CalamaroS/FOT-wirless-device/0_Documenti/ESP32/TTGO_esp32_pinout.webp

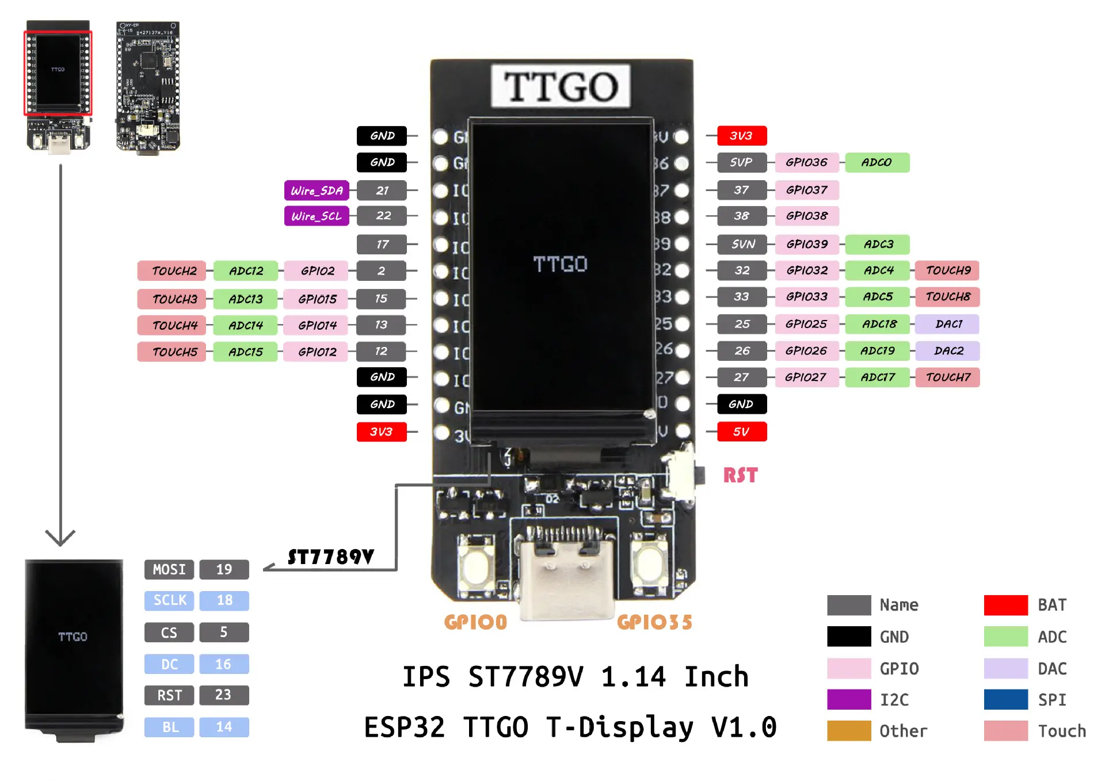
0_Documenti/ESP32/TTGO_esp32_pinout.webp
