CalamaroS/FOT-wirless-device/0_Documenti/ESP32/TTGO_esp32_footprint.webp

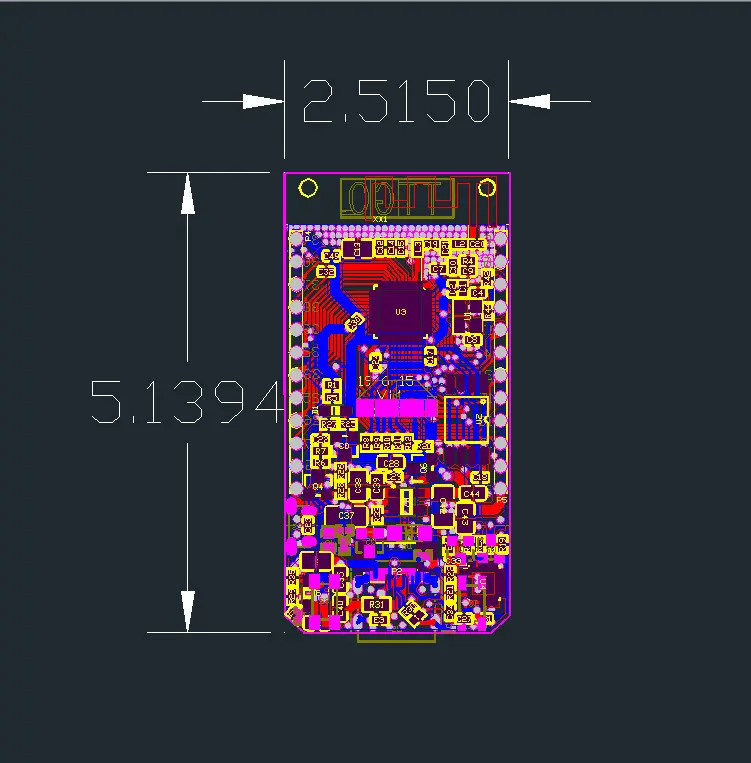
0_Documenti/ESP32/TTGO_esp32_footprint.webp
