CalamaroS/FOT-wirless-device/README.md

# FOT-wirless-device
Master thesis project: Development of a wireless device for lung function assessment in horses.
