CalamaroS/FOT-wirless-device/5_PCB_cad/HorseFOT_thomas_SD_P_abs/HorseFOT_thomas_v1.kicad_pcb

## KiCad design 5_PCB_cad/HorseFOT_thomas_SD_P_abs/HorseFOT_thomas_v1.kicad_pcb (2024-09-25)

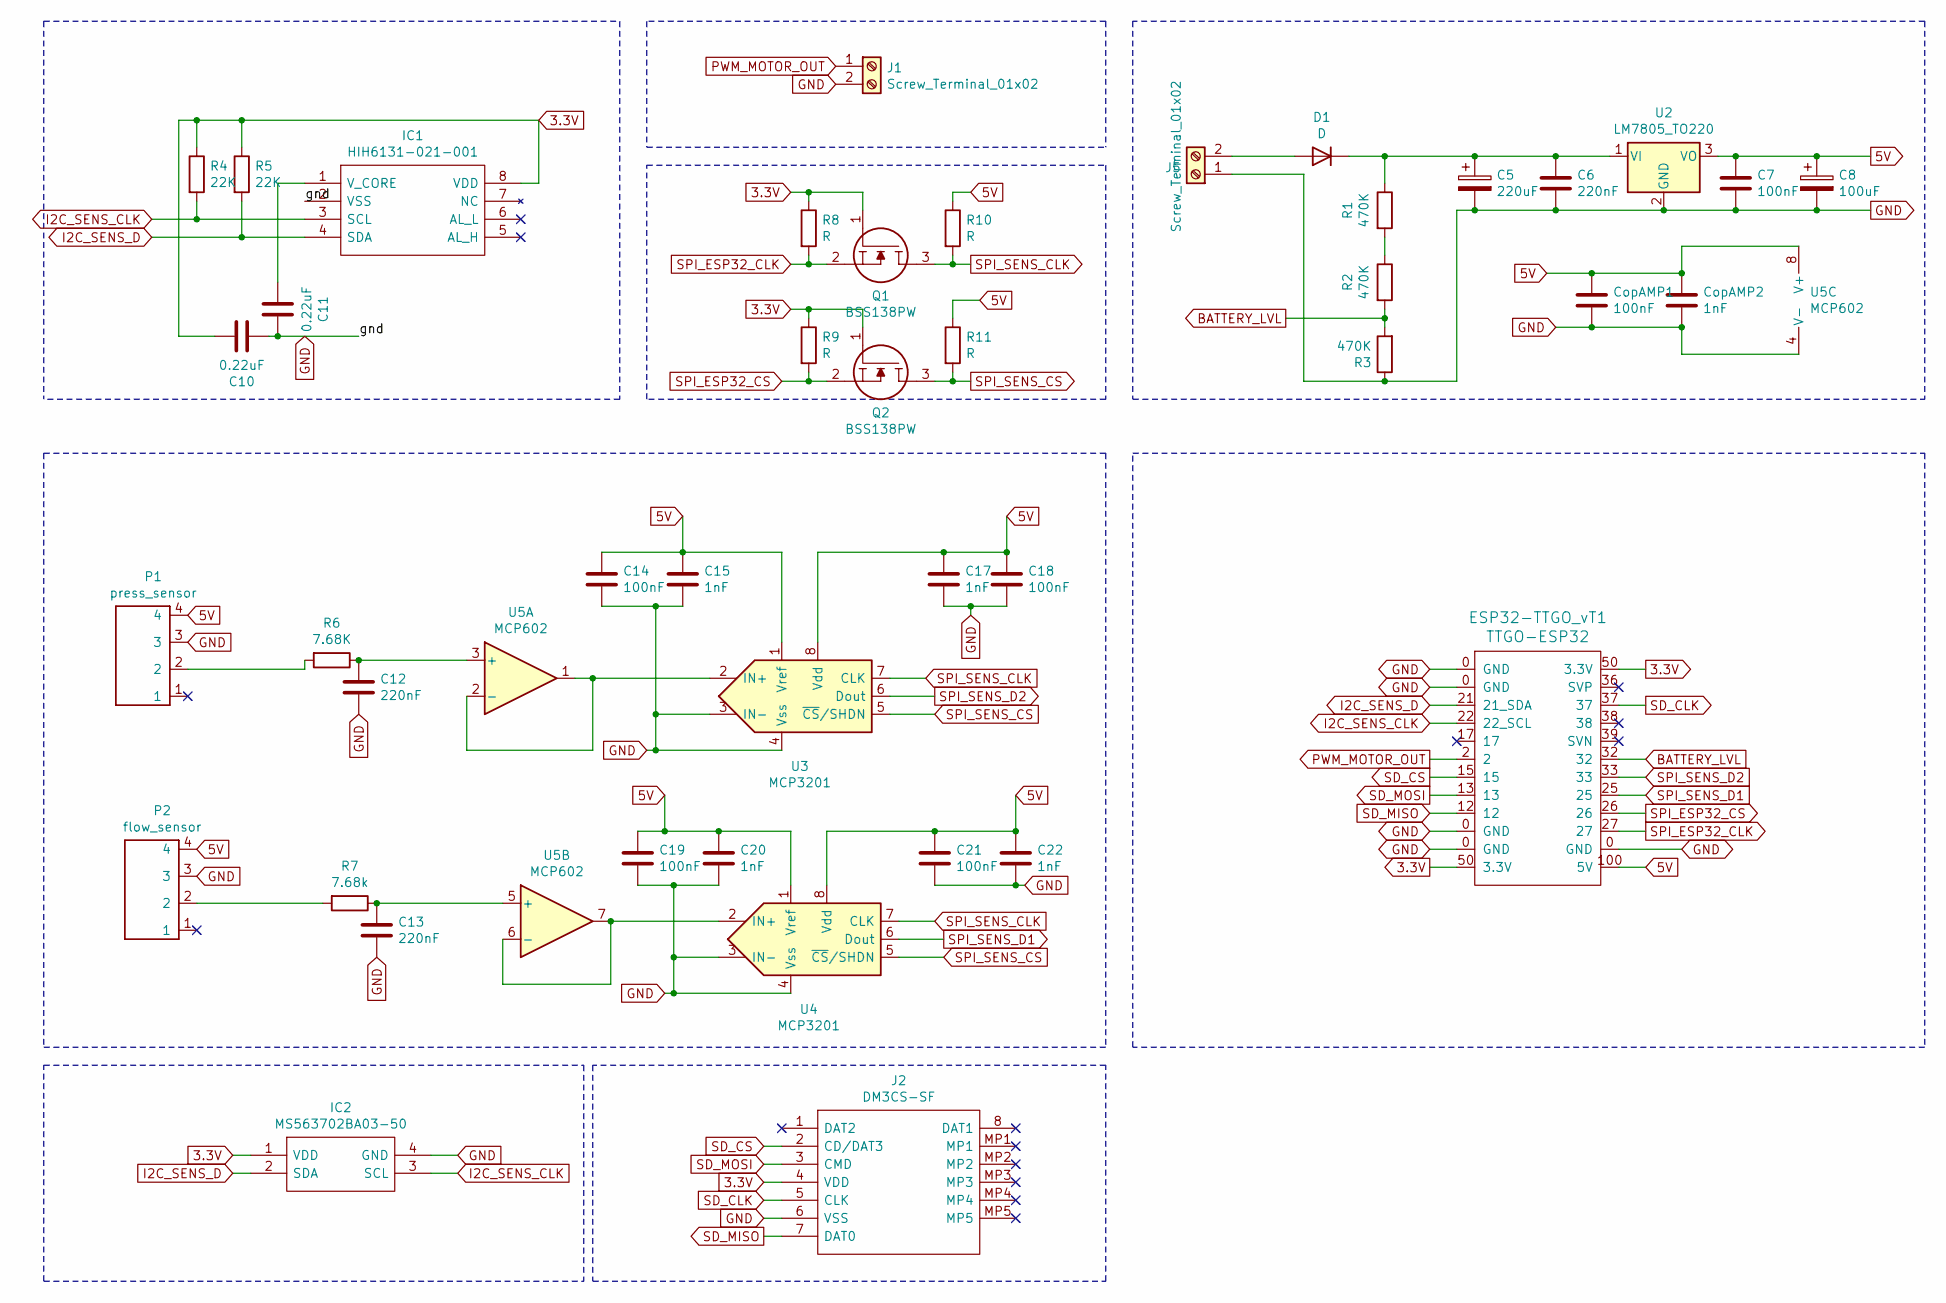
[picture p9: schematic HorseFOT_thomas_v1.sch]

Parts:
C5: 220uF; EEE1AA221P
C6, C12, C13: 220nF; C_1206_3216Metric_Pad1.33x1.80mm_HandSolder
C7, C14, C18, C19, C21: 100nF; C_1206_3216Metric_Pad1.33x1.80mm_HandSolder
C8: 100uF; EEE1AA221P
C10, C11: 0.22uF; C_1206_3216Metric_Pad1.33x1.80mm_HandSolder
C15, C17, C20, C22: 1nF; C_1206_3216Metric_Pad1.33x1.80mm_HandSolder
CopAMP1: 100nF; C_1206_3216Metric_Pad1.33x1.80mm_HandSolder
CopAMP2: 1nF; C_1206_3216Metric_Pad1.33x1.80mm_HandSolder
D1: D; D_1206_3216Metric
ESP32-TTGO_vT1: TTGO-ESP32; ESP32-TTGO_vT
IC1: HIH6131-021-001; HIH6131021001; Manufacturer_Part_Number HIH6131-021-001
IC2: MS563702BA03-50; MS5637_1; Manufacturer_Part_Number MS563702BA03-50; Mouser Part Number 824-MS563702BA03-50
J1, J5: Screw_Terminal_01x02; TerminalBlock_bornier-2_P5.08mm
J2: DM3CS-SF; Manufacturer_Part_Number DM3CS-SF; Mouser Part Number 798-DM3CSSF
P1: press_sensor; ELVR-L01D-pressure_sensor
P2: flow_sensor; ELVR-L01D-pressure_sensor
Q1, Q2: BSS138PW; SOT65P210X110-3N; Manufacturer_Part_Number BSS138PW; Mouser Part Number N/A
R1, R2, R3: 470K; R_1206_3216Metric
R4, R5: 22K; R_1206_3216Metric
R6: 7.68K; R_1206_3216Metric
R7: 7.68k; R_1206_3216Metric
R8, R9, R10, R11: R; R_1206_3216Metric_Pad1.30x1.75mm_HandSolder
U2: LM7805_TO220; SOT230P700X180-4N
U3, U4: MCP3201; SOIC127P600X175-8N
U5: MCP602; SOP65P490X110-8N

Connections:
3.3V: C10.1, ESP32-TTGO_vT1.50 (3.3V), IC1.8 (VDD), IC2.1 (VDD), J2.4 (VDD), Q1.1, Q2.1, R4.1, R5.1, R8.1, R9.1
5V: C7.1, C8.1, C14.1, C15.1, C17.1, C18.1, C19.1, C20.1, C21.1, C22.1, CopAMP1.1, CopAMP2.1, ESP32-TTGO_vT1.100 (5V), P1.4, P2.4, R10.1, R11.1, U2.3 (VO), U3.1 (Vref), U3.8 (Vdd), U4.1 (Vref), U4.8 (Vdd), U5.8 (V+)
BATTERY_LVL: ESP32-TTGO_vT1.32, R2.2, R3.2
GND: C5.2, C6.2, C7.2, C8.2, C10.2, C11.1, C12.2, C13.2, C14.2, C15.2, C17.2, C18.2, C19.2, C20.2, C21.2, C22.2, CopAMP1.2, CopAMP2.2, ESP32-TTGO_vT1.0 (GND), IC1.2 (VSS), IC2.4 (GND), J1.2, J2.6 (VSS), J5.1, P1.3, P2.3, R3.1, U2.2 (GND), U3.3 (IN-), U3.4 (Vss), U4.3 (IN-), U4.4 (Vss), U5.4 (V-)
I2C_SENS_CLK: ESP32-TTGO_vT1.22 (22_SCL), IC1.3 (SCL), IC2.3 (SCL), R4.2
I2C_SENS_D: ESP32-TTGO_vT1.21 (21_SDA), IC1.4 (SDA), IC2.2 (SDA), R5.2
unnamed: C5.1, C6.1, D1.1 (K), R1.1, U2.1 (VI)
unnamed: C11.2, IC1.1 (V_CORE)
unnamed: C12.1, R6.1, U5.3 (+)
unnamed: C13.1, R7.1, U5.5 (+)
unnamed: D1.2 (A), J5.2
unnamed: P1.2, R6.2
unnamed: P2.2, R7.2
unnamed: R1.2, R2.1
unnamed: U3.2 (IN+), U5.1, U5.2 (-)
unnamed: U4.2 (IN+), U5.6 (-), U5.7
PWM_MOTOR_OUT: ESP32-TTGO_vT1.2, J1.1
SD_CLK: ESP32-TTGO_vT1.37, J2.5 (CLK)
SD_CS: ESP32-TTGO_vT1.15, J2.2 (CD/DAT3)
SD_MISO: ESP32-TTGO_vT1.12, J2.7 (DAT0)
SD_MOSI: ESP32-TTGO_vT1.13, J2.3 (CMD)
SPI_ESP32_CLK: ESP32-TTGO_vT1.27, Q1.2, R8.2
SPI_ESP32_CS: ESP32-TTGO_vT1.26, Q2.2, R9.2
SPI_SENS_CLK: Q1.3, R10.2, U3.7 (CLK), U4.7 (CLK)
SPI_SENS_CS: Q2.3, R11.2, U3.5 (~CS~/SHDN), U4.5 (~CS~/SHDN)
SPI_SENS_D1: ESP32-TTGO_vT1.25, U4.6 (Dout)
SPI_SENS_D2: ESP32-TTGO_vT1.33, U3.6 (Dout)

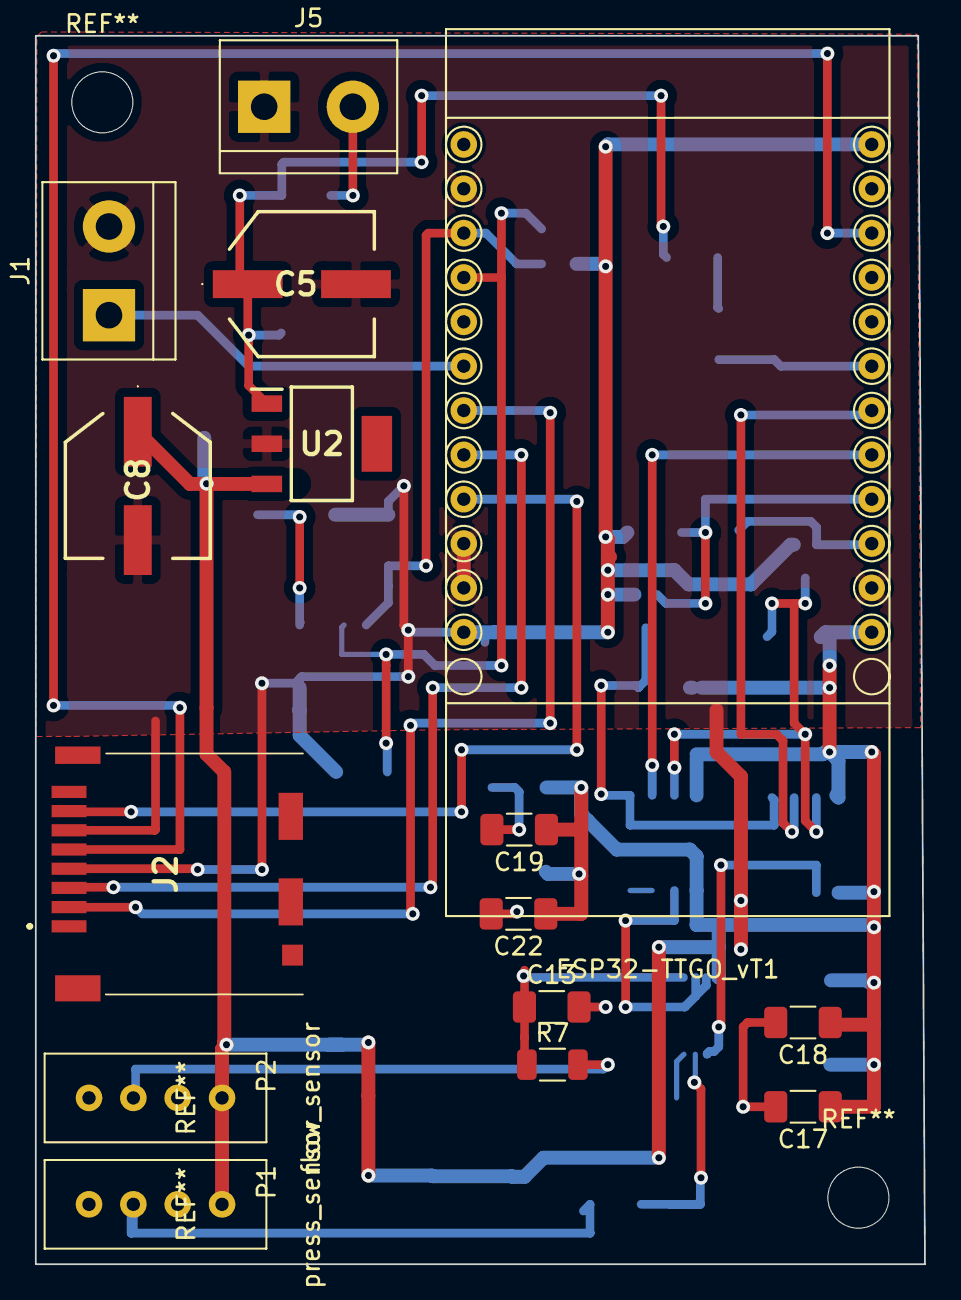
[picture p10: board HorseFOT_thomas_v1.kicad_pcb from above]

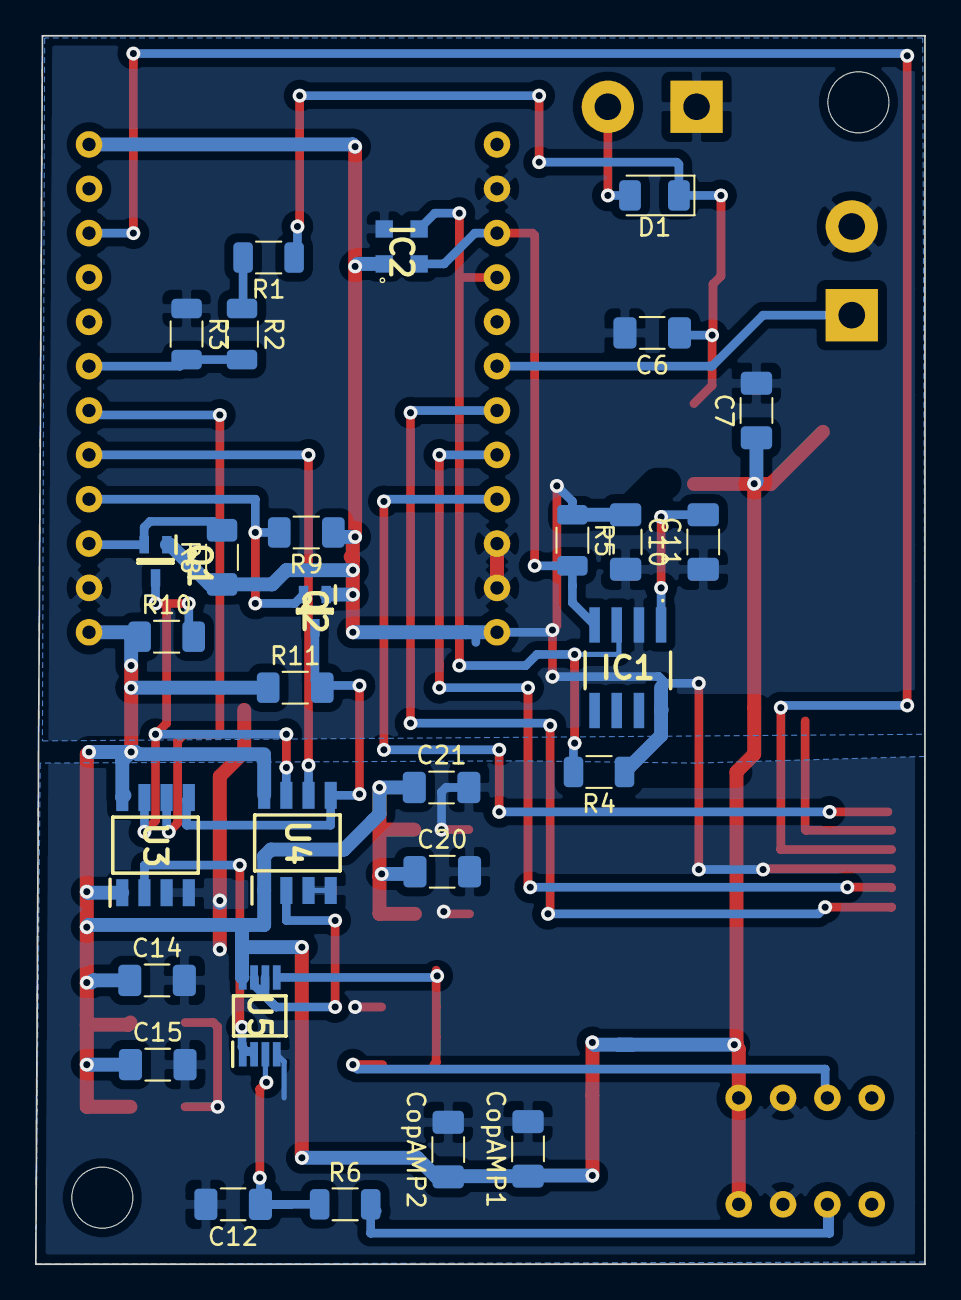
[picture p11: board HorseFOT_thomas_v1.kicad_pcb from below]

Board: 2 copper layers, 50.9 x 70.4 mm, 44 parts (29 on the bottom side), 27 nets.
